sinara-hw/DIO_SMA/README.md

# DIO_SMA
DIO_SMA 8 channel isolated digital input/output EEM 

## Design Files

Design files (schematics, PCB layouts, BOMs) can be found at [DIO_SMA/Releases](https://github.com/sinara-hw/DIO_SMA/releases).

## Wiki

More information can be found on the [wiki](https://github.com/sinara-hw/DIO_SMA/wiki).
