sinara-hw/DIO_SMA/(list of files, drawings)

Other design files:
DIO-SMA.schdoc
DIO-SMA_Supply.SchDoc
DIO_SMA.PrjPCB
