sinara-hw/DIO_SMA/(threads)

Thread 1 (2018-06-13):

DIO SMA 1.2

marmeladapk, 2018-06-13:
_From @gkasprow on [2018-02-01 17:10](https://github.com/sinara-hw/sinara/issues/503)_

- [x] reverse DIP switch channels to match front panel channel assignment
- [x] ground front panel

marmeladapk, 2018-06-13:
_From @jordens on [2018-03-12 16:35](https://github.com/sinara-hw/sinara/issues/503#issuecomment-372375129)_

The bottom SMA (channel 7) interferes with the handle. To use it that channel, the handle needs to be removed.

marmeladapk, 2018-06-13:
_From @gkasprow on [2018-03-15 14:42](https://github.com/sinara-hw/sinara/issues/503#issuecomment-373399961)_

hm, I connected the SMA a few times and didn't notice that. Can you take a pic ?

marmeladapk, 2018-06-13:
_From @jordens on [2018-03-15 17:22](https://github.com/sinara-hw/sinara/issues/503#issuecomment-373456766)_

Will do.

marmeladapk, 2018-06-13:
_From @jordens on [2018-03-22 19:14](https://github.com/sinara-hw/sinara/issues/503#issuecomment-375425563)_

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

marmeladapk, 2018-06-13:
_From @gkasprow on [2018-03-22 19:18](https://github.com/sinara-hw/sinara/issues/503#issuecomment-375426787)_

maybe on my board the SMA connector was assembled at slightly different angle or I have smaller SMA nut :)

marmeladapk, 2018-06-13:
_From @gkasprow on [2018-03-22 19:22](https://github.com/sinara-hw/sinara/issues/503#issuecomment-375427738)_

@jordens do you observe this issue on all boards you have?
Maybe some cut-out in the handle would do the job? Not very elegant but if we make the connectors placed denser, we limit access space to them.

marmeladapk, 2018-06-13:
_From @jordens on [2018-03-22 19:34](https://github.com/sinara-hw/sinara/issues/503#issuecomment-375430985)_

Yeah. I can wiggle it and file it off. It's on two out of three and the connector where the connector is at a slight angle. Could also be viewed as a QC issue.
8 SMA on 4 HP is too dense IMHO (but that's old news).

Closed 2020-11-29.

Thread 2 (2019-06-14):

TTL SMA isolation from front panel

sbourdeauducq, 2019-06-14:
In each SMA-DIO the two banks are supposed to be galvanically isolated, but the grounds of the SMA connectors are shorted by the front panel.
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

Closed 2019-06-14.

Thread 3 (2019-08-07):

replace DC/DC and other changes from DIO_BNC

jordens, 2019-08-07:
DIO_SMA should see an update and adopt the improvements from DIO_BNC:

* use the beefier Murata DC/DC (and https://github.com/sinara-hw/DIO_BNC/issues/3)
* panel grounding

gkasprow, 2019-08-08:
I'm afraid these nice Murata modules are no longer produced.

gkasprow, 2020-11-29:
2W  TMH1205S were used

Closed 2020-11-29.

Thread 4 (2019-10-31):

Potential issue causing obvious rising edges

ghost, 2019-10-31:
### Issue description

A user of [ARTIQ](https://github.com/m-labs/artiq) reported an [issue](https://forum.m-labs.hk/d/40-output-of-the-ttlout/7) about an obvious rising edge when the DIO generates 5-ms pulses. I was able to reproduce the same oscilloscope output as him, which is:
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_Fig. 1: TTL4 output on an oscilloscope._

On the other hand, the rising edge of a longer pulse (400 ms) looked like this:
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_Fig. 2: TTL5 output on an oscilloscope._

### Steps to reproduce the issue

1. Copy [this Python script](https://gist.github.com/HarryHo90sHK/8731ff8008e99e76628f8671208e8116) to your local folder.
2. Prepare an ARTIQ system with a TTL output. For my test, an SMA-DIO is connected to a Kasli on EEM port 0. Note that the original poster was [using a BNC-DIO instead](https://forum.m-labs.hk/d/40-output-of-the-ttlout/8), but that also produced a similar shape on the waveform.
3. Use ARTIQ to run the script. Please follow the [official manual](https://m-labs.hk/artiq/manual-beta/index.html) for details.
4. Trace the output waveform of TTL4. The rising edge of the first 5-ms pulse is very obvious (Fig. 1).
5. Trace the output waveform of TTL5 (or TTL7). The rising edge is less obvious but can still be seen (Fig. 2).

### Expected result

The rising edge of a pulse of any length on a TTL output should be sharp under this magnification (10 ms per grid).

_CC: @sbourdeauducq_

hartytp, 2019-10-31:
Odd. I’ve never seen anything like that. Do you have the termination switches on?

If you have access to the hw can you stick a scope in a few places down the signal path (from lvds buffer to output) and see where this effect originated? Also worth checking nothing funny is going on with the supplies.

gkasprow, 2019-10-31:
Don't you have AC coupling turned on in your scope?

dhslichter, 2019-10-31:
Are you using a scope probe or connecting the signal directly in to the scope?

hartytp, 2019-10-31:
> Don't you have AC coupling turned on in your scope?

The other thing I did wonder about was if this is related to the AC-coupled grounds. Depends whether an isolated power supply is used in the apparatus.

dnadlinger, 2019-10-31:
A follow-up to the original forum report indicates that this also happens on DIO-BNC. (I've never seen anything like that on ours, though.)

gkasprow, 2019-10-31:
It looks like some AC-coupling effect. Could be scope ground connected to one of four upper IOs and the signal observed on one of 4 lower outputs wi

HarryHo90sHK, 2019-11-01:
Dear all,

Thank you for the replies. I've just used the oscilloscope again, using DC coupling and a 10x probe, connecting to the ground of the SMA head that is under test. However, the same shape of the rising edge is there.

hartytp, 2019-11-01:
> Thank you for the replies. I've just used the oscilloscope again, using DC coupling and a 10x probe, connecting to the ground of the SMA head that is under test. However, the same shape of the rising edge is there.

I don't follow you here...do you mean the tip of the probe was connected to the SMA ground (in which case, where was the probe ground connected)? Or, do you mean that the probe tip was connected to the SMA centre pin and the probe ground was connected to the SMA ground?

Can you try connecting the probe ground to the PCB ground instead of the SMA ground?

gkasprow, 2019-11-01:
Can you connect the second channel of the scope to the 5V supply of the driver IC?

JunkiKimQ, 2020-01-10:
Hi,

I'm here to report the same issue with our SMA-DIO. I also tested with/without termination switch on.

I saw a similar rising edge without termination switch on, while there was no similar rising edge is happening with the switch on. The problem with the switch is that it lowers high voltage levels from 3.6V to 2.4V, not sufficient to trigger the device we have.

Here's the picture of an oscilloscope:
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

the scope was DC-coupled, and when I add a tee and 50ohm termination, the voltage rise was sharp again but the output voltage was 1.8V, half of 3.6V.

JunkiKimQ, 2020-01-13:
> Can you connect the second channel of the scope to the 5V supply of the driver IC?

I checked two test points on the board:
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

5.554V and 5.528V, seems reasonable.

JunkiKimQ, 2020-01-13:
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
measured 5V (ch2) while sending pulse (ch1, 1.5ms width)

gkasprow, 2020-01-13:
OK, this looks very intriguing. I asked my student to recreate it with exactly the same setup as yours. Hopefully, tomorrow we will be able to check what is going on.

gkasprow, 2020-01-13:
In the past, I observed very strange behavior of the transceivers. They seemed to be sensitive to light (sic!). Their high level was dependent on whether I shined strong IR light from incandescent lamp or not. It did not work with visible LED light. It does not explain the issue you are reporting but can be related.

gkasprow, 2020-01-14:
We recreated the issue.
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
I loaded 2 outputs with 50R and observed power supply. There is 50mV drop with small ripples
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

The input signal looks fine. The output issue is the same even with 50Ohm termination.
I can also confirm that a high level depends on lighting conditions.
Set output H, turn on the strong LED light (I used my mobile phone), observe ~500mV change in the output voltage. Here is the behavior. Output terminated with 50Ohm.
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
The pattern was created by moving the phone above the board. This is not EMI from phone, the same effect is created by keeping the LED lamp and obscuring the light path.

gkasprow, 2020-01-14:
The light sensitivity of the silicon IC is nothing new. I'm surprised that the black opaque package still leaks enough light that produces a measurable effect. I wouldn't connect these to effects.

jordens, 2020-01-14:
Is this the LVDS-CMOS converter or the isolator? The isolator should be magnetic coupling not optical, right?

JunkiKimQ, 2020-01-14:
With 50ohm, the high level is around 2V. Isn't it unacceptable? This is what I read from this github page:
>Outputs can supply 5V into 25Ohm, and can tolerate an indefinite short-circuit to ground.

gkasprow, 2020-01-14:
It is just the TTL buffer chip. We have 30Ohm in series with a 25built-in resistor. It looks like we have to lower the resistor to ensure at least 2.1V in H state.

sbourdeauducq, 2020-01-14:
The wiki suggests that the card would output 5V when connected to a 25-ohm resistor. If that's incorrect or misleading, it should be edited.

gkasprow, 2020-01-14:
That's right. I replaced it with statement: Outputs can supply valid TTL level into 50Ohm load

jordens, 2020-01-14:
And it's only 12.5 Ohm + 30 Ohm since we take two in parallel.

JunkiKimQ, 2020-01-14:
> That's right. I replaced it with statement: Outputs can supply valid TTL level into 50Ohm load

I'm not sure. I'm certainly not electronics guy, but I was thinking ttl high should be either 3.3V or 5V. and less than 2V with 50ohm (or even with 2.1V high) doesn't satisfy any of them.

gkasprow, 2020-01-14:
TTL does not care about the load. Input levels are the same. 50R load is used to match the impedance only, mainly for long cables. TTL input H is >2V and L is <0.8V. The same with LVTTL, that's why in TTL world you can safely connect 3.3 and 5V domains, which you cannot do in the CMOS world.
So 2V still meets the specification of H state. The surprising fact is that with 30+12Ohm : 50Ohm divider we almost get 2V at the beginning of the pulse train. Later on, we get nearly 2.5V at the end of the pulse train, without changing the supply. The same amplitude change happens when we use non-terminated output but the value is higher.
I have one suspicion that needs to be verified. The two drivers are connected in parallel. This means that during the transition state, the skew causes cross-condiction and momentary short circuit which generates a ground bounce. However, this does not explain why after a series of pulses the circuit works properly. Maybe it heats and changes the propagation delay...

gkasprow, 2020-01-14:
Another idea is that we use ICs from some weird series with some bugs. I will order one from another source and give it a try.

JunkiKimQ, 2020-01-15:
> TTL does not care about the load. Input levels are the same. 50R load is used to match the impedance only, mainly for long cables. TTL input H is >2V and L is <0.8V. The same with LVTTL, that's why in TTL world you can safely connect 3.3 and 5V domains, which you cannot do in the CMOS world.

I think I've got your point, couldn't understand 100% though.

So my issue is, it can be out of focus though, if I were to trigger another device that needs at least ~4V high to trigger, how can I use sma-dio to do that? it can be triggered without impedance matching (>>50ohm), but the rising edge leads very long and indeterministic delay (~1ms +- 100us).

sbourdeauducq, 2020-01-15:
You can put a terminator and use a comparator or other kind of TTL receiver that would trigger at ~2V and output 5V next to the target device. The wire length between the TTL receiver and the target device can be short so there are no issues with transmission line effects.

gkasprow, 2020-01-15:
The DIO modules have series termination, so if your module has hi-Z input, you can use it without termination and still preserve the pulse shapes.
I ordered the transceiver ICs from other source and will test them. I have a suspicion that existing ones come from unauthorized source, even though they were bought from trusted vendor. I already met a few times fake ICs with much worse parameters than specified. The TI logo on the chips I have look suspicious.

gkasprow, 2020-11-16:
The ICs I ordered have a different logo and markings than the ICs that cause problems. I will swap them and see if that helps.

LTGiardino, 2020-11-24:
Hi. We've been having the exact same issue.
We found this behavior connecting the output directly into a scope (TBS2000).
Same thing using a Red Pitaya with a 10x scope probe and also with sma-sma Mini-Circuits attenuators.

Each pulse after a long period of ground state gets this same rising edge situation.
After the initial skewed edges it seems to stabilize and works correctly for every pulse afterwards.

gkasprow, 2020-11-24:
OK, I found the issue.
It's charge build-up on the termination FET.
When I touch the FET gate with scope probe the problem disappears.
I suggest adding 10k resistors between G and S of all termination FETs.

gkasprow, 2020-11-24:
It also explains light sensitivity - it's LED that behaves as a solar cell and opens the termination FET :) Thanks @marmeladapk for discovery of this effect

sbourdeauducq, 2020-11-25:
Good find!

> I suggest adding 10k resistors between G and S of all termination FETs.

Has this been tested and should we rework the existing boards accordingly?

HarryMakes, 2021-01-05:
After reworking one of the Technosystem boards by adding the 10k ohm resistor between G and S of each of the FETs, the issue has been confirmed to be fixed. To make it simple, below shown is the trace for only calling [`t4()`](https://forum.m-labs.hk/d/40-output-of-the-ttlout) on a TTL output channel.

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

HarryMakes, 2021-01-05:
Today, I tested a DIO_SMA v1.1 again and reproduced the problem, with slight difference in the edge shape. For simplicity, I only carried out tests to only call [`t4()`](https://forum.m-labs.hk/d/40-output-of-the-ttlout) on a TTL output channel. Below shown is the trace before doing any rework:

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

Then, we reworked the board by adding the 10k ohm resistor across each of the termination LEDs. After rework, the issue has been confirmed to be fixed. Plus, shining those LEDs with strong light (e.g. phone flashlight, laser pointer) do not change the voltage waveform. Below shown is the trace after rework:

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

HarryMakes, 2021-05-14:
Hi to all! Using Greg's fix ([link](https://github.com/sinara-hw/DIO_SMA/issues/4#issuecomment-733306488)), we can no longer find rising edges that last several microseconds. But recently I have observed a similar behaviour on a shorter time scale. The difference is that the rising edge last for ~200ns instead. This seem to occur only on some units of v1.2 from TechnoSystems. Attaching oscilloscope screenshots as follows:

IO0:
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

IO4:
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

Unlike the problem I found in the past, this is not negatively impacting DIO accuracy or performance, and it might not be a problem at all. I would appreciate if anyone would know an explanation. Thank you!

gkasprow, 2021-05-14:
The TTL standard defines a valid H level as above 2.1V. So this still conforms to the standard.
The buffers we use are CMOS devices and they can be non-linear close to the rails.
How long is your cable? Is It terminated?

HarryMakes, 2021-05-17:
@gkasprow Thank you for the feedback and info about the TTL standard.

The cable is around 30cm long. It is an SMA coaxial cable where one end is connected to an SMA-BNC adapter for the oscilloscope, and the other end is connected directly to the SMA of the TTL channel. We set the oscilloscope in 1M ohm impedance. We didn't use any additional terminators.

TopQuark12, 2021-06-18:
Think the issue is just impedance mismatch in test setup, see the screenshots with 1M input impedance vs 50 ohm input impedance.

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

Closed 2021-06-18.

Thread 7 (2020-08-05):

DC/DC issue

gkasprow, 2020-08-05:
the RKZ-1205S which is an assembly option for NXE2S1205MC has an incompatible footprint. It is too long but can be assembled in an elevated way.

gkasprow, 2020-09-10:
TMH1205S is compatible

Closed 2020-11-29.

Thread 8 (2020-11-06):

SMA holes on front panel are too small

HarryMakes, 2020-11-06:
According to the front panel design ([link here](https://github.com/sinara-hw/DIO_SMA/releases/download/v1.1/Panel.7z)), the drilled holes for fitting in the SMA connectors have a diameter of 7 mm. However, measurement on the actual front panel in production shows a diameter of 7.7 mm would be required instead. This should be fixed in order to generate a correct DXF file. Thanks.

gkasprow, 2020-11-06:
Feel free to fix it and publish modifications. It's open-source design.

HarryMakes, 2020-11-09:
Greg, thanks for the reply. I'm not sure how to contribute to the mechanical designs since I don't think I have the required licenses or OSes for the software (Altrium Designer?). Currently I'm using a "dirty" approach of converting the outputted DXF back to AutoCAD DWG with some online converter, editing the DWG with the [official online AutoCAD webapp](https://web.autocad.com), and converting it back to DXF again.

Plus, I'm only suggesting 7.7 mm based on the measurement @sbourdeauducq  and I made on some manufactured panels. Certain inaccuracy might not have been accounted for. Therefore, it would be great if anyone actually involved in manufacturing at least one working front panel can contribute. I wouldn't mind taking the initiative regardless.

gkasprow, 2020-11-29:
The panel design has 7.0mm holes. I don't know who changed the cutouts, I didn't get any feedback.

Closed 2020-11-30.

Thread 9 (2020-11-24):

add discharge resistors

gkasprow, 2020-11-24:
https://github.com/sinara-hw/DIO_BNC/issues/15

Closed 2020-11-29.

Thread 12 (2020-12-01):

CPCIS Compatibility

dtcallcock, 2020-12-01:
[There was discussion](https://github.com/sinara-hw/DIO_BNC/issues/11) of making this board 160mm long so that there was an isolated DIO module available right away for CPCIS.  Just checking this was decided against and not just forgotten.

gkasprow, 2020-12-16:
I don't remember what the conclusion was.
We already have 160mm EEM  16-CH DIO_MCX and individually isolated 16-CH DIO MCX in native CPCIS format. Each of them can support 8 channels without mezzanine.

dtcallcock, 2020-12-16:
> We already have ... individually isolated 16-CH DIO MCX in native CPCIS format

I hadn't spotted [that new repository](https://github.com/sinara-hw/DIO_MCX_Isolated) when I posted this.  Seems like there is little need either way then.

Closed 2020-12-16.

Thread 13 (2021-06-18):

Fast output rise time causes unexpected termination FET turn on

TopQuark12, 2021-06-18:
Under guidance from @sbourdeauducq , it was discovered that a combination of fast output rise time and variation in the BSS138L parasitic capacitance and turn-on voltage, may cause an unexpected turn-on on some BSS138L termination FETs during output switching.

This effect causes a weird slope to appear towards the top of the pulse that lasts for ~1us, and is more pronounced when driving unterminated loads. Even on output channels that do not exhibit this issue, measuring the Vgs of the FETs shows the margin between the output working as expected and the issue showing is very slim.

In the below screenshots, the yellow trace shows the output connected to scope with 50cm coax and with 1M input termination. Blue trace is the Vgs of the BSS138L FET.

The issue on failed output channels:
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

Output on "good" channels, but Vgs shows it is marginally working:
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

Adding a 1nF cap across gate and source of the FET fixes the issue.
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

hartytp, 2021-06-18:
good catch!

sbourdeauducq, 2021-06-18:
Does it improve the situation on those cards where the effect is not so pronounced, e.g. https://github.com/sinara-hw/DIO_SMA/issues/4#issuecomment-841132777 ?

TopQuark12, 2021-06-18:
It does!

Before (Vgs not measured, probing it changes the output signal on this channel):
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

After soldering 1nF cap:
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

gkasprow, 2021-06-18:
Does it exist in the boards where the resistor between G and S was installed to eliminate the previous issue related to signal edges (https://github.com/sinara-hw/DIO_SMA/issues/4)?

sbourdeauducq, 2021-06-18:
Yes. And if you look at the duration of the disturbance it's in the ballpark of the RC product of that resistor with the gate capacitance.

Closed 2021-07-28.

Thread 15 (2022-01-19):

v1.4 resistors changes

filipswit, 2022-01-19:
Due to wrong resistive divider, enable of isolators and transceiver direction couldn't be changed. Resistors values are changed to:

<html>
<body>
<!--StartFragment-->

Des. | Value
-- | --
R195 | 3k9
R194 | 1k
R196 | 510
R38 | 470
R39 | 470
R220 | 3k9
R217 | 1k
R44 | 510
R42 | 470
R43 | 470

<!--EndFragment-->
</body>
</html>

gkasprow, 2022-12-30:
These changes are needed only for v1.4. V1.4.1 and v1.4.2 do not need them because the source of the issues was removed.

Closed 2023-11-30.

Thread 16 (2022-05-09):

v1.4.1 changelog

filipswit, 2022-05-09:
- DC/DC converter replaced with available one
- added FETs to control LEDs

Closed 2023-11-30.

Thread 18 (2022-05-20):

IC15 EN

gkasprow, 2022-05-20:
disconnect pin 5 of IC15
It has 20k input resistor anyway but the voltage should not exceed 6V

Closed 2022-12-29.

Thread 20 (2024-07-10):

DIOT version

gkasprow, 2024-07-10:
We are moving all boards to the DIOT form factor.
The idea is to make a 16-channel SMA version. We have a 6HP panel, so that will fit.
The question is - do we want a higher speed design or isolated in groups of 4 as it is now
Or, we should make two versions. One line DIO-MCX but with SMAs, another isolated.
Or, we make assembly variants with dc/dc converters or without them.

gkasprow, 2024-09-01:
Let's go for the isolated version, channels isolated in groups of 4;
8 channels placed on main board, 8 additional channels placed on mezzanine.
Channel numbering must be as in other boards
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
Use [standard](https://www.we-online.com/components/products/datasheet/61301621821.pdf) low cost 2.54 goldpin connectors and headers
We will fit easily with 10 or 12mm stacking height
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

Thread 21 (2024-08-09):

v1.4.3 missing project output files, outjob file and panel directory

MorganTL, 2024-08-09:
With the v1.4.3rc1 commit, the outjob files and panel directory got deleted.
Also  the project-output and the panel zip files are missing from the v1.4.3 release

gkasprow, 2024-09-01:
It's Technosystem policy to include only source files
You can extract panel from Pcbdoc file.
Just use previous version of the Outjob

kaolpr, 2024-09-02:
@MorganTL Thank you for raising this issue.

At TechnoSystem, we have established policies regarding the release publication process that guide how we handle design files and artifacts. Specifically, we have decided not to include Altium output job files in our commits and output artifacts in release packages. This decision comes from our belief that manufacturers are best equipped to generate the appropriate job files and artifacts based on their specific production processes and equipment.

Furthermore, we believe that including output job files or production artifacts in the release could lead to the misconception that a working product can be achieved simply by downloading projects and submitting files to any EMS company. Our experience has shown that delivering a high-quality product requires conscious decisions based on in-depth knowledge of the project (e.g., while answering EQ from PCB manufacturers). It is our concern that supporting this misconception may have a negative influence on the perception of the Sinara project.

For front panel designs, we now embed the STEP files directly within the PCB design files, rather than maintaining them as separate Altium PCB files. This approach aligns with our current practice of designing panels as full 3D models, which we find to be more accurate.

jordens, 2024-09-02:
@kaolpr AFAICT you are excluding the `OutJob` from the Documentation (in the sense of the license) and thus from the scope of the license. I can see why and it might be just fine.

What about the panel Documentation, is that also licenced like the rest? Or stated differently: how do you go from PCB Documentation to panel STEP files?

gkasprow, 2024-09-02:
Just select the panel and generate step file

Thread 22 (2025-07-25):

Misprints on silkscreen corresponding to IO direction

HarryPoon000, 2025-07-25:
https://git.m-labs.hk/sinara-hw/datasheets/issues/97

IO direction when DIP switch is closed (`ON`) should be input instead of output

HarryPoon000, 2025-07-25:
The IO direction LEDs also indicates that the switch closed is output mode

Closed 2025-07-25.
