sinara-hw/DIO_SMA/(commit log)

2018-07-06 panel update
    [PANEL_DIO_SMA.PcbDoc]
2020-11-30 fixed panel and cosmetics
    [DIO-SMA.schdoc, DIO_SMA.PrjPCB, PANEL_DIO_SMA.PcbDoc]
2021-07-28 v1.3rc1 fixed #13
    [DIO-SMA.schdoc, DIO_SMA.PrjPCB]
2021-11-26 v1.4 added alternate isolators
    [DIO-SMA.schdoc, DIO-SMA_Supply.SchDoc, DIO_SMA.PrjPCB, PANEL_DIO_SMA.PcbDoc]
2023-11-30 v1.4.3rc1 - Connectors position aligned - Fiducial Targets moved - Polygons modified to maintain isolated parts clearance - Tenting via rule added - P_version parameter added - Schemmatic template up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
    [DIO-SMA.schdoc, DIO-SMA_Supply.SchDoc, DIO_SMA.PrjPCB, PANEL_DIO_SMA.PcbDoc]
